DicerosB/SparrowCompass/Software/CubeIDE/Screenshot 2025-11-19 004516.jpg

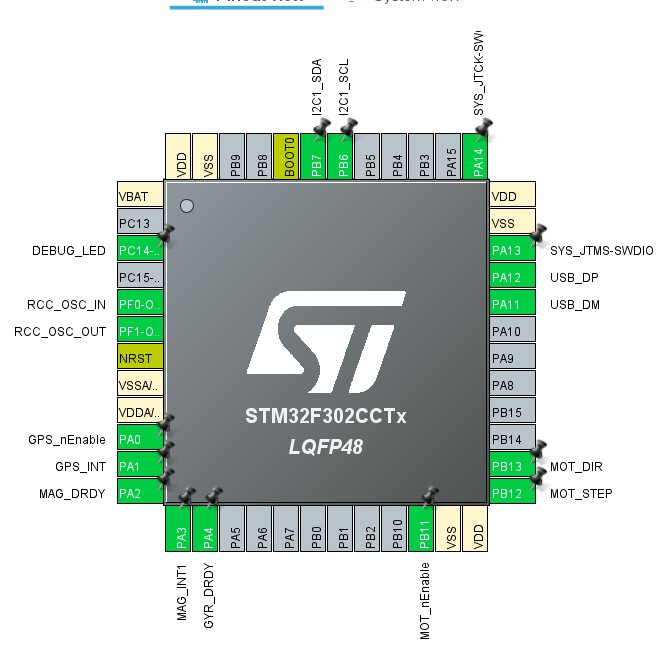
Software/CubeIDE/Screenshot 2025-11-19 004516.jpg
