DicerosB/SparrowCompass/Hardware/Revision2.0/BOM.xlsx

Reference | Qty | Value | DNP | Footprint | Datasheet | Cost | Link | total
C1;C2;C3;C6;C8;C11;C16;C19;C21;C23;C25;C31 | 12 | 2u2 |  | Capacitor_SMD:C_0603_1608Metric | ~ | 0.09 | https://www.mouser.de/ProductDetail/Murata-Electronics/GRM188C81C225MA12D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 | 1.08
C4;C5;C9;C12;C17;C18;C20;C22;C24;C28 | 10 | 100n |  | Capacitor_SMD:C_0603_1608Metric | ~ | 0.09 | https://www.mouser.de/ProductDetail/KEMET/C0603C104Z4VACTU?qs=t9q%2F2xDdjt80hHjNGtEgzg%3D%3D | 0.9
C7;C10 | 2 | 10u |  | Capacitor_SMD:CP_Elec_4x5.3 | ~ | 0.05 | https://www.mouser.de/ProductDetail/Knowles-Illinois-Capacitor/AVEZ106M16B12T-F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 | 0.1
C13;C14;C15;C29;C30 | 5 | 220n |  | Capacitor_SMD:C_0603_1608Metric | ~ | 0.09 | https://www.mouser.de/ProductDetail/Murata-Electronics/GRM188R71E224JA88J?qs=QzBtWTOodeUQv4s17XcJEQ%3D%3D | 0.45
C26;C27 | 2 | 6p |  | Capacitor_SMD:C_0603_1608Metric | ~ | 0.09 | https://www.mouser.de/ProductDetail/Murata-Electronics/GCM1885C2A6R0CA16D?qs=QzBtWTOodeW2ALKkh2LyBA%3D%3D | 0.18
D1;D2;D3;D4;D5;D6;D7 | 7 | LED |  | LED_SMD:LED_0603_1608Metric | ~ | 0.15 | https://www.mouser.de/ProductDetail/Wurth-Elektronik/150060BS75000?qs=LlUlMxKIyB2DLLpXQThavA%3D%3D | 1.05
IC1 | 1 | NEO-M8N-0 |  | NEO-M8N-0:NEO-M8T | https://www.u-blox.com/sites/default/files/NEO-M8-FW3_DataSheet_%28UBX-15031086%29.pdf | 27.09 | https://www.mouser.de/ProductDetail/u-blox/NEO-M8N-0?qs=zW32dvEIR3unZhZI0KRbew%3D%3D | 27.09
IC2 | 1 | LSM303AGRTR |  | LSM303AGRTR:LGA-12 | http://www.st.com/content/ccc/resource/technical/document/datasheet/74/c4/19/54/62/c5/46/13/DM00177685.pdf/files/DM00177685.pdf/jcr:content/translations/en.DM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 | 4 | https://www.mouser.de/ProductDetail/STMicroelectronics/LSM303AGRTR?qs=dTJS0cRn7oj2TlQhcroMCw%3D%3D | 4
IC3 | 1 | DRV8834RGER |  | DRV8834RGER:QFN50P400X400X100-25N-D | http://www.ti.com/lit/gpn/drv8834 | 2.35 | https://www.mouser.de/ProductDetail/Texas-Instruments/DRV8834RGER?qs=UFc95S4Z4CbZvVPj6YuR6w%3D%3D | 2.35
IC4 | 1 | AEDR-8300-1Q2 |  | AEDR-8300-1Q2:AEDR83001Q2 | https://www.digikey.ph/en/products/detail/broadcom-limited/AEDR-8300-1Q2/4573056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 | 8.31 | https://www.mouser.de/ProductDetail/Broadcom-Avago/AEDR-8300-1Q2?qs=RuhU64sK2%252Bt%252BHTtC7LwVEw%3D%3D | 8.31
IC6 | 1 | MCP73833T-AMI_MF |  | MCP73833T-AMI_MF:SON50P300X300X100-11N-D | https://datasheet.datasheetarchive.com/originals/distributors/SFDatasheet-4/sf-00090109.pdf | 0.98 | https://www.mouser.de/ProductDetail/Microchip-Technology/MCP73833T-AMI-MF?qs=Fxu3fLyJv8epbqy6GsGQQA%3D%3D | 0.98
J2 | 1 | Conn_Coaxial_Small |  | Connector_Coaxial:U.FL_Hirose_U.FL-R-SMT-1_Vertical | ~ | 1.25 | https://www.mouser.de/ProductDetail/Hirose-Connector/U.FL-R-SMT-110?qs=kL1ClTr6oBoOdtqlGQpQrQ%3D%3D | 1.25
J3 | 1 | USB4105-GF-A-060 |  | USB4105_GF_A_060:GCT_USB4105-GF-A-060 |  | 0.67 | https://www.mouser.de/ProductDetail/GCT/USB4105-GF-A-060?qs=QNEnbhJQKvY2mocwNJzgfA%3D%3D | 0.67
L1 | 1 | 220R |  | Inductor_SMD:L_1210_3225Metric | ~ | 3.06 | https://www.mouser.de/ProductDetail/Wurth-Elektronik/7687709221?qs=sq%252BaO8iX7yo5Y4jfKYVibg%3D%3D | 3.06
PS1;PS2 | 2 | ZLDO1117QG33TA |  | ZLDO1117QG33TA:SOT230P700X180-4N | https://www.diodes.com//assets/Datasheets/products_inactive_data/ZLDO1117.pdf | 0.46 | https://www.mouser.de/ProductDetail/Diodes-Incorporated/ZLDO1117QG33TA?qs=AsTZqt%2FmeqkYux4yhEuliw%3D%3D | 0.92
R1;R2 | 2 | 5k1 |  | Resistor_SMD:R_0603_1608Metric | ~ | 0.09 | https://www.mouser.de/ProductDetail/Vishay/CRCW06035K11FKEA?qs=2Ta4L6IlF3huCvbRI1eJUw%3D%3D | 0.18
R3;R4;R5;R14;R17;R21;R22;R23 | 8 | 470R |  | Resistor_SMD:R_0603_1608Metric | ~ | 0.09 |  | 0.72
R6 | 1 | 1k |  | Resistor_SMD:R_0603_1608Metric | ~ | 0.09 |  | 0.09
R7 | 1 | 80R |  | Resistor_SMD:R_0603_1608Metric | ~ | 0.09 |  | 0.09
R8;R9 | 2 | 200R |  | Resistor_SMD:R_0603_1608Metric | ~ | 0.09 |  | 0.18
R10 | 1 | 330R |  | Resistor_SMD:R_0603_1608Metric | ~ | 0.09 |  | 0.09
R11;R12;R13;R15;R16;R18;R19;R24 | 8 | 10k |  | Resistor_SMD:R_0603_1608Metric | ~ | 0.09 |  | 0.72
R20 | 1 | 20k |  | Resistor_SMD:R_0603_1608Metric | ~ | 0.09 |  | 0.09
U1 | 1 | L3GD20 |  | Package_LGA:LGA-16_4x4mm_P0.65mm_LayoutBorder4x4y | http://www.st.com/st-web-ui/static/active/en/resource/technical/document/datasheet/DM00036465.pdf | 14.03 | https://www.mouser.de/ProductDetail/STMicroelectronics/A3G4250DTR?qs=Ld7sMN6XJzCU8%252BkHd1RE7g%3D%3D | 14.03
U2 | 1 | TPD2EUSB30 |  | Package_TO_SOT_SMD:Texas_DRT-3 | http://www.ti.com/lit/ds/symlink/tpd2eusb30a.pdf | 0.48 | https://www.mouser.de/ProductDetail/Texas-Instruments/TPD2EUSB30DRTR?qs=%2Fqzd9s%252BcLd6bPJi5HXCDvw%3D%3D | 0.48
U3 | 1 | STM32F302CCTx |  | Package_QFP:LQFP-48_7x7mm_P0.5mm | https://www.st.com/resource/en/datasheet/stm32f302cc.pdf | 5.23 | https://www.mouser.de/ProductDetail/STMicroelectronics/STM32F302CCT7?qs=NoqMqJKvPFJLAf54HThcFA%3D%3D | 5.23
Y1 | 1 | XRCGB25M000F3M00R0 |  | XRCGB25M000F3M00R0:XRCGB | https://www.murata.com/products/productdata/8801059864606/SPEC-XRCGB25M000F3M00R0.pdf | 0.215 | https://www.mouser.de/ProductDetail/Murata-Electronics/XRCGB25M000F3M00R0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 | 0.215
 |  | RFID Module |  |  |  | 5.67 | https://funduinoshop.com/elektronische-module/wireless-iot/rfid-nfc/pn532-nfc-rfid-v3-modul-fuer-arduino-und-co. | 5.67
 |  | GPS Antenna |  |  |  | 3.15 | https://www.mouser.de/ProductDetail/KYOCERA-AVX/9000440F0-AA12L0150?qs=jRuttqqUwMS53dQeffbIFQ%3D%3D | 3.15
 |  | Nema-Flat Stepper Motor |  |  |  | 22.5 | https://www.reichelt.de/de/de/shop/produkt/schrittmotor_nema_flat02_1_8_0_5_a_1_75_v-335315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 | 22.5
 |  |  |  |  |  |  | + PCB | 14
 |  |  |  |  |  |  | Summe: | 119.825
