DicerosB/SparrowCompass/Hardware/component_lib/LIB_EE-SX1320/EE-SX1320/3D/EE-SX1320.stp

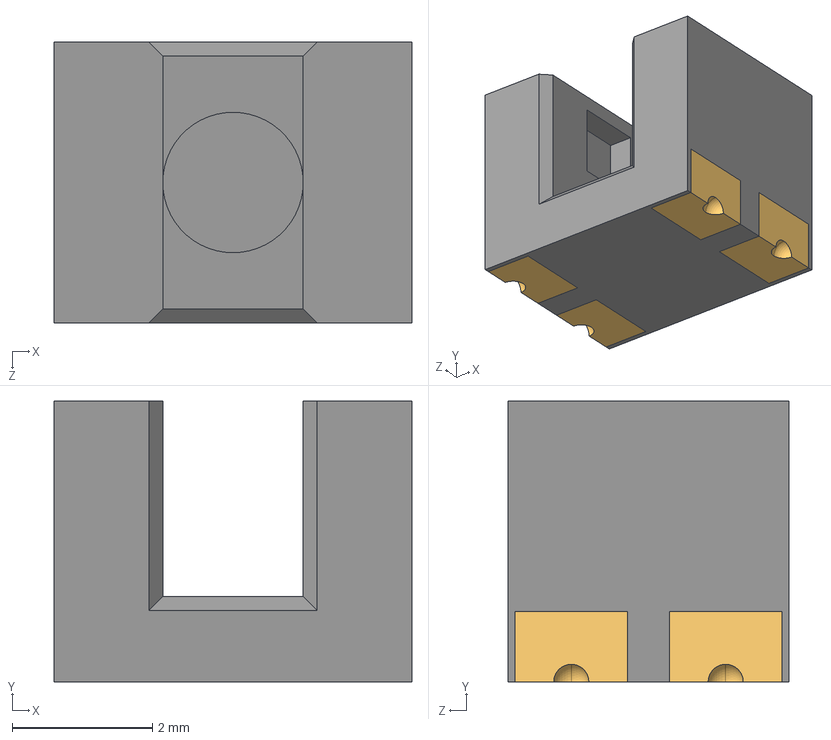
[picture p2: CAD file, 2026-05-11]
Hardware/component_lib/LIB_EE-SX1320/EE-SX1320/3D/EE-SX1320.stp
5.10 x 4.00 x 4.00 mm
