DicerosB/SparrowCompass/Hardware/component_lib/LIB_LDL1117S33R/LDL1117S33R/3D/LDL1117S33R.stp

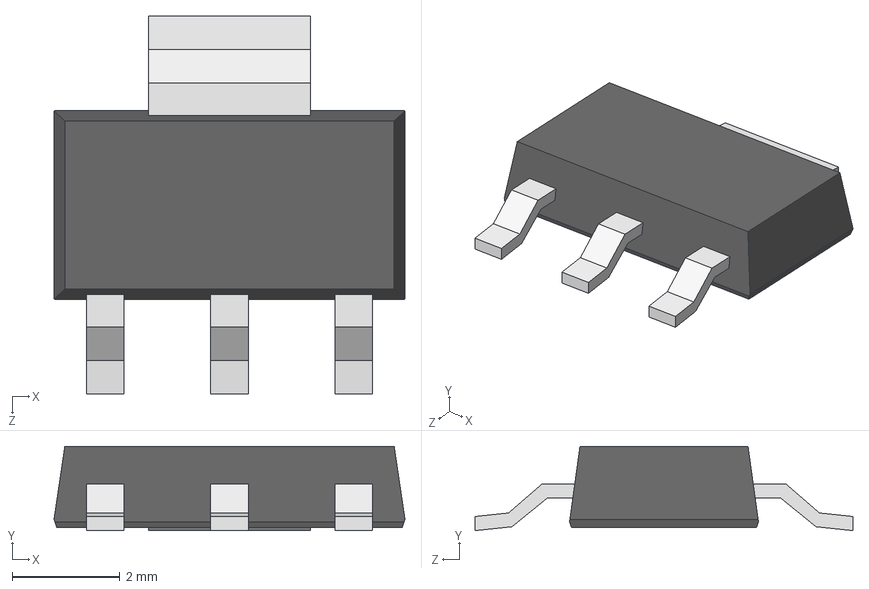
[picture p3: CAD file, 2026-05-11]
Hardware/component_lib/LIB_LDL1117S33R/LDL1117S33R/3D/LDL1117S33R.stp
6.50 x 1.56 x 7.00 mm
