DicerosB/SparrowCompass/Hardware/component_lib/LIB_LSM9DS1TR/LSM9DS1TR/3D/LSM9DS1TR.stp

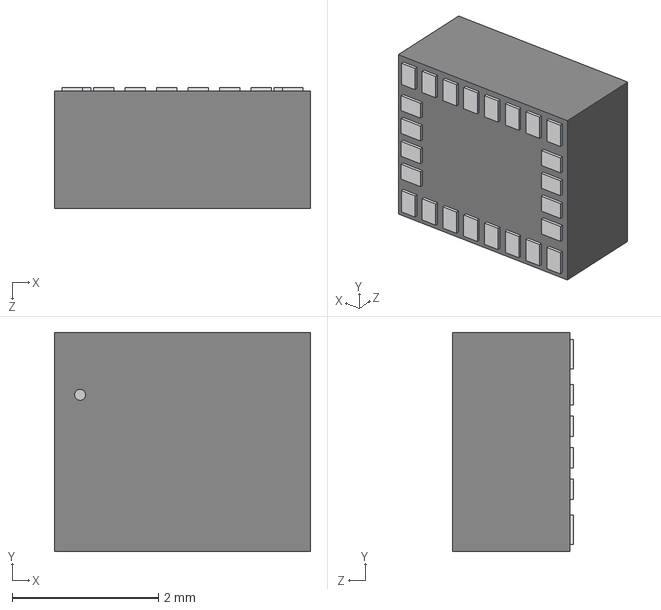
[picture p4: CAD file, 2026-05-11]
Hardware/component_lib/LIB_LSM9DS1TR/LSM9DS1TR/3D/LSM9DS1TR.stp
3.50 x 3.00 x 1.65 mm
