DicerosB/SparrowCompass/Hardware/component_lib/LIB_TESEO-LIV3F/TESEO-LIV3F/3D/TESEO-LIV3F.stp

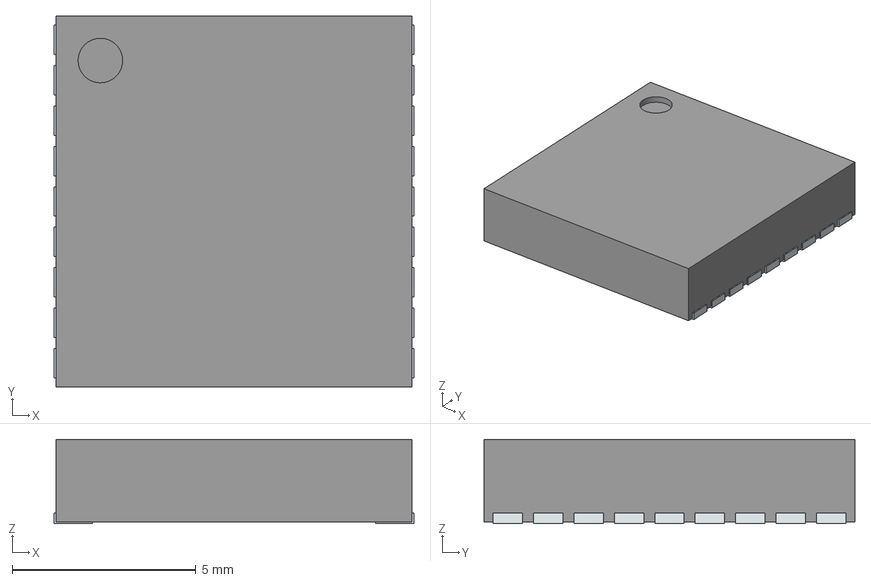
[picture p5: CAD file, 2026-05-11]
Hardware/component_lib/LIB_TESEO-LIV3F/TESEO-LIV3F/3D/TESEO-LIV3F.stp
9.80 x 10.1 x 2.30 mm
PinsArrayLR
