DicerosB/SparrowCompass/Hardware/component_lib/LIB_XC6806A42011-G/XC6806A42011-G/3D/XC6806A42011-G.stp

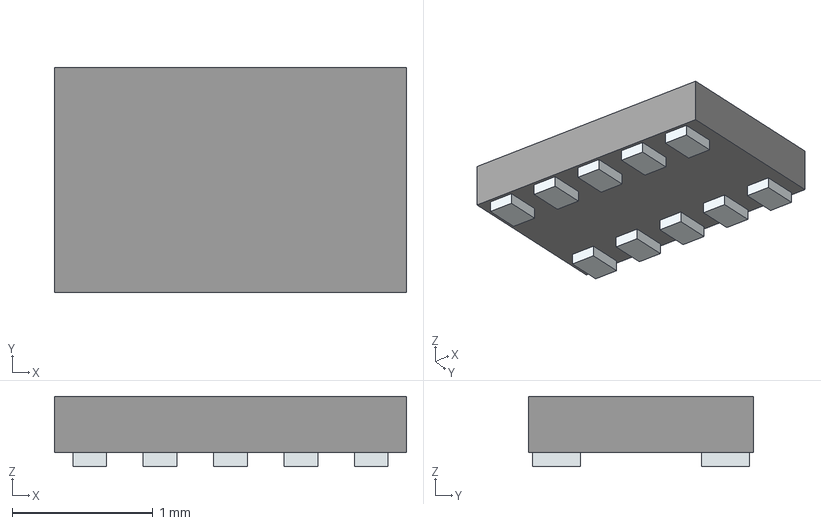
[picture p6: CAD file, 2026-05-11]
Hardware/component_lib/LIB_XC6806A42011-G/XC6806A42011-G/3D/XC6806A42011-G.stp
2.50 x 1.60 x 0.5 mm
Pins
