DicerosB/SparrowCompass/Hardware/component_lib/LIB_JS102011SAQN/JS102011SAQN/3D/JS102011SAQN.stp

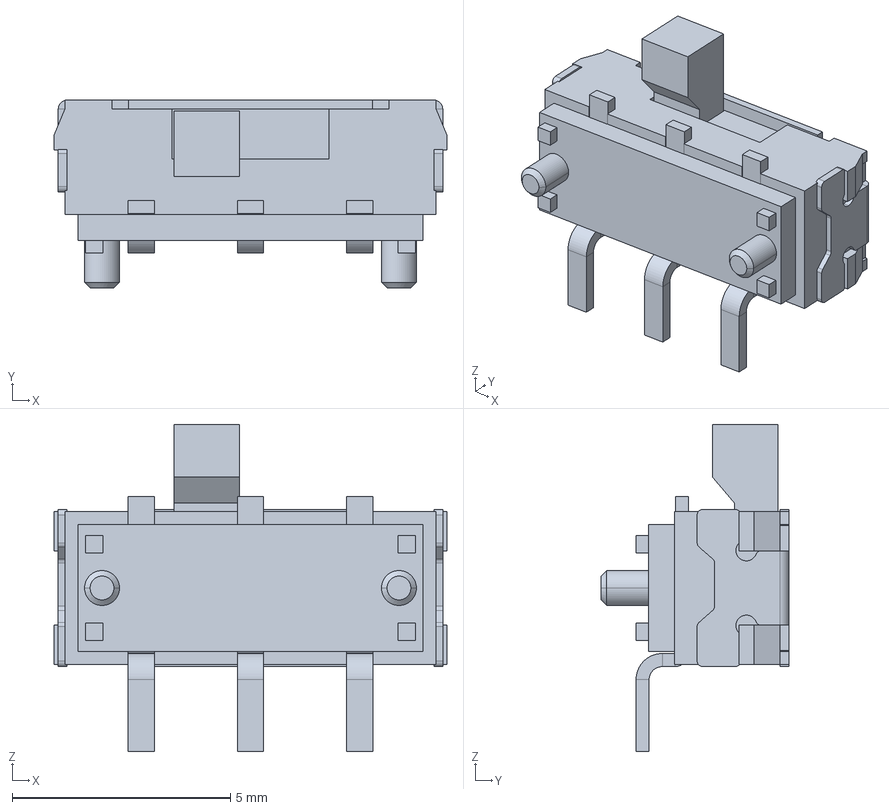
[picture p7: CAD file, 2026-05-22]
Hardware/component_lib/LIB_JS102011SAQN/JS102011SAQN/3D/JS102011SAQN.stp
9.00 x 4.30 x 7.50 mm
