DicerosB/SparrowCompass/(list of files, cad)

Other CAD files:
Hardware/component_lib/LIB_EE-SX1320/EE-SX1320/Allegro/ee-sx1320.psm
Hardware/component_lib/LIB_EE-SX1320/EE-SX1320/DEHDL/ee_sx1320/chips/chips.prt
Hardware/component_lib/LIB_JS102011SAQN/JS102011SAQN/Allegro/js102011saqn.psm
Hardware/component_lib/LIB_JS102011SAQN/JS102011SAQN/DEHDL/js102011saqn/chips/chips.prt
Hardware/component_lib/LIB_LDL1117S33R/LDL1117S33R/Allegro/sot230p700x180-4n.psm
Hardware/component_lib/LIB_LDL1117S33R/LDL1117S33R/DEHDL/ldl1117s33r/chips/chips.prt
Hardware/component_lib/LIB_LSM9DS1TR/LSM9DS1TR/Allegro/lga-24l_3x3_5x1mm_.psm
Hardware/component_lib/LIB_LSM9DS1TR/LSM9DS1TR/DEHDL/lsm9ds1tr/chips/chips.prt
Hardware/component_lib/LIB_TESEO-LIV3F/TESEO-LIV3F/Allegro/son110p970x1010x230-18n.psm
Hardware/component_lib/LIB_TESEO-LIV3F/TESEO-LIV3F/DEHDL/teseo_liv3f/chips/chips.prt
Hardware/component_lib/LIB_XC6806A42011-G/XC6806A42011-G/Allegro/xc6806a42011g.psm
Hardware/component_lib/LIB_XC6806A42011-G/XC6806A42011-G/DEHDL/xc6806a42011_g/chips/chips.prt
