DicerosB/SparrowCompass/TODO.md

# Hardware

## Schematic

- fanout remaining GPIO
- dim all LEDs
- reinforce power
- current limit Motor driver
- make microstepping configurable
- protect Reset Line
- add on/off switch

## Dimension

- shrink overall dimensions
- relocate important LEDs

## Parts

- add RFID Reader
- mabye add Display

# Software

## Arduino Library

## Bootloader

# Documentation
