DicerosB/SparrowCompass/Hardware/Revision2.0/SparrowCompass.pdf

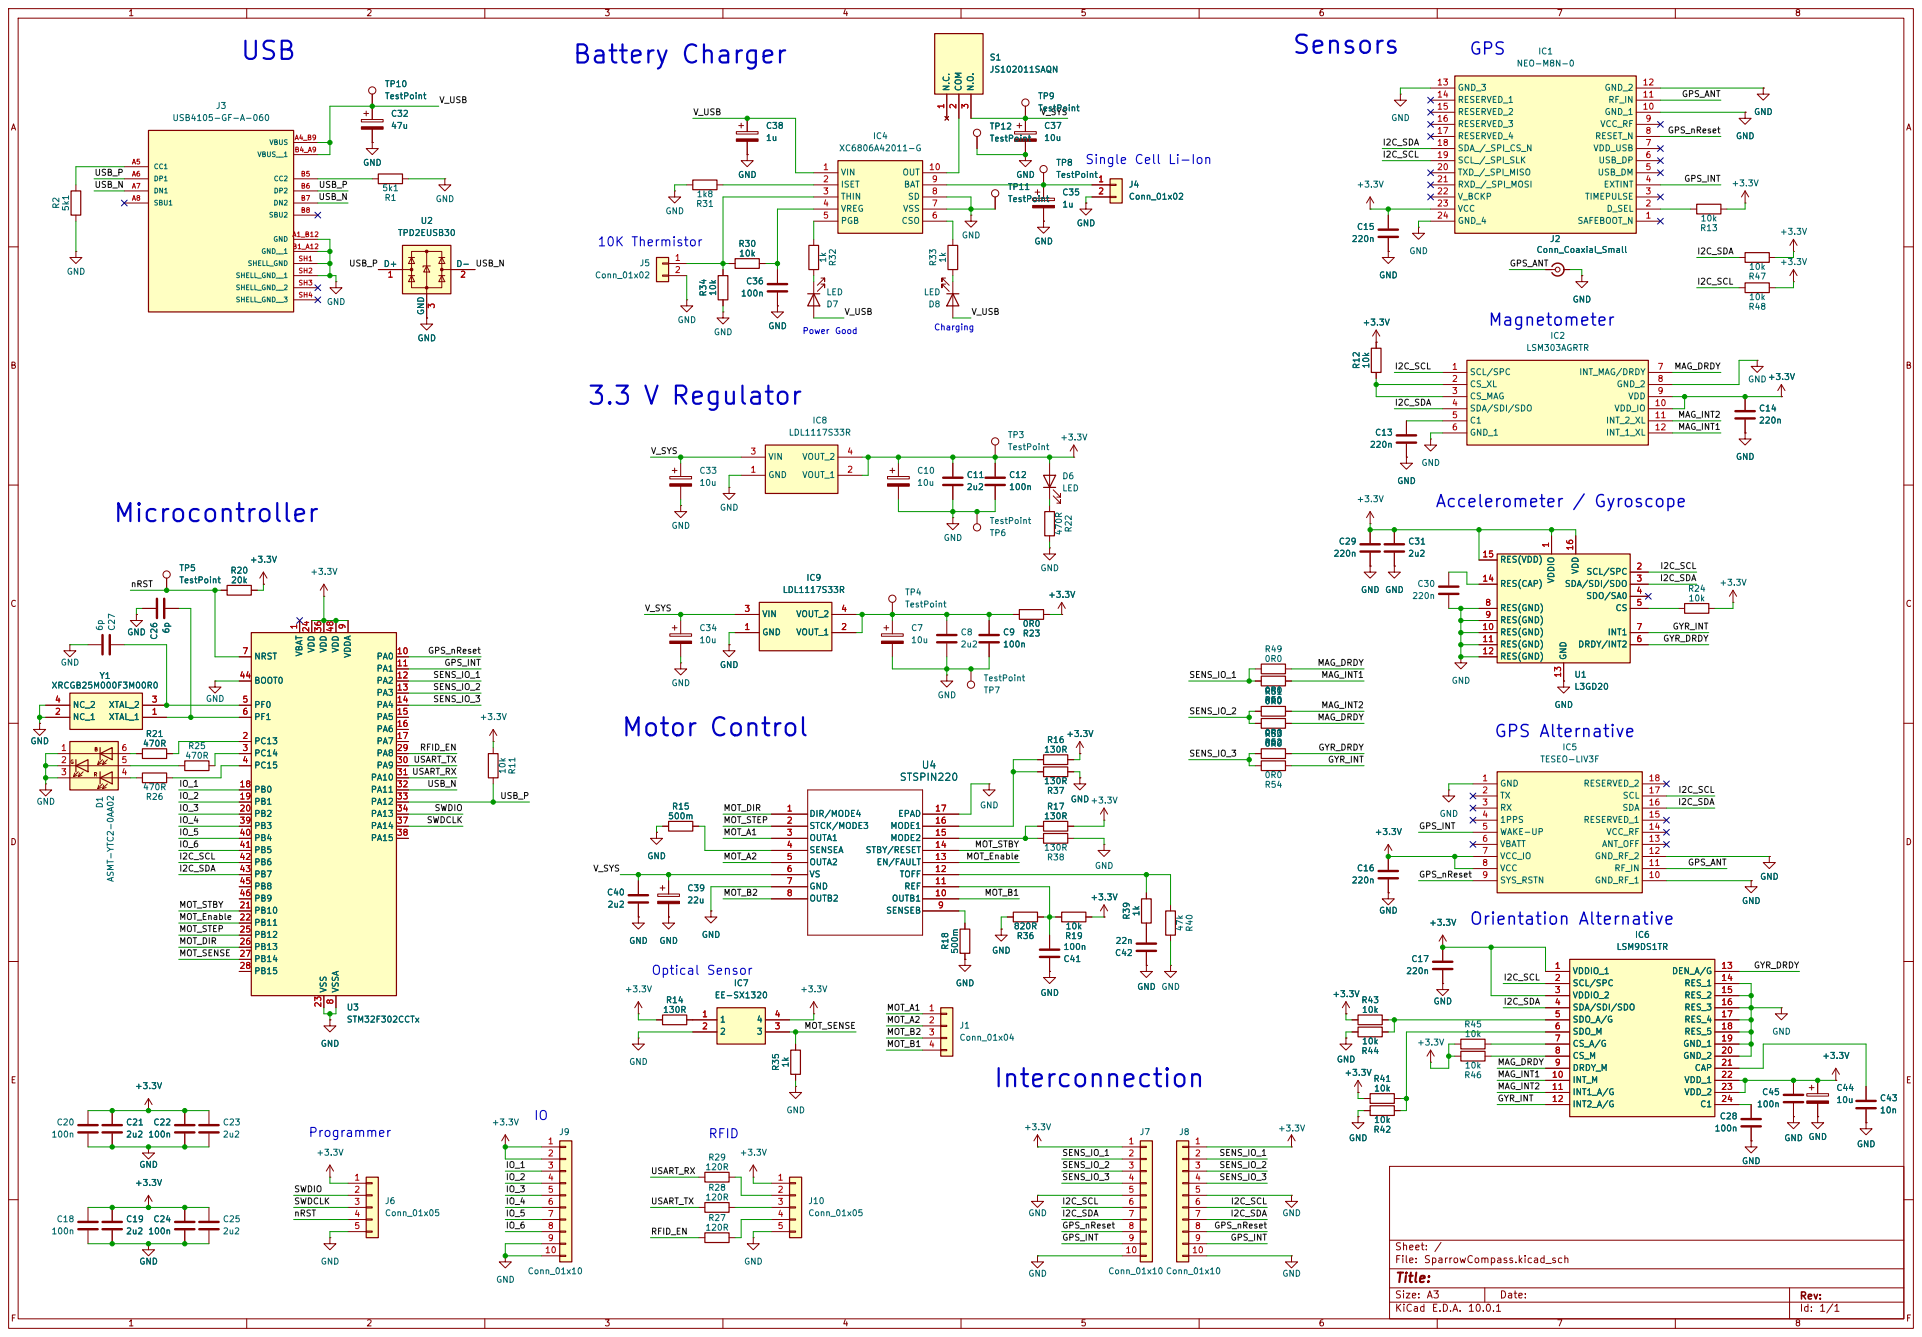
[picture p8: page 1]

Size: A3 | Rev: | F Date:
KiCad E.D.A. 10.0.1 | Id: 1/1
