DicerosB/SparrowCompass/(list of files, drawings)

Other design files:
Hardware/component_lib/LIB_JS102011SAQN/JS102011SAQN/Altium/JS102011SAQN.PcbLib
Hardware/component_lib/LIB_JS102011SAQN/JS102011SAQN/Altium/JS102011SAQN.SchLib
Hardware/component_lib/LIB_LDL1117S33R/LDL1117S33R/Altium/LDL1117S33R.SchLib
Hardware/component_lib/LIB_LDL1117S33R/LDL1117S33R/Altium/SOT230P700X180-4N.PcbLib
Hardware/component_lib/LIB_TESEO-LIV3F/TESEO-LIV3F/Altium/SON110P970X1010X230-18N.PcbLib
Hardware/component_lib/LIB_TESEO-LIV3F/TESEO-LIV3F/Altium/TESEO-LIV3F.SchLib
Hardware/component_lib/LIB_XC6806A42011-G/XC6806A42011-G/Altium/XC6806A42011-G.SchLib
Hardware/component_lib/LIB_XC6806A42011-G/XC6806A42011-G/Altium/XC6806A42011G.PcbLib
