DicerosB/SparrowCompass/Hardware/Revision2.0/SparrowCompass.kicad_pcb

## KiCad design Hardware/Revision2.0/SparrowCompass.kicad_pcb (2026-06-11)

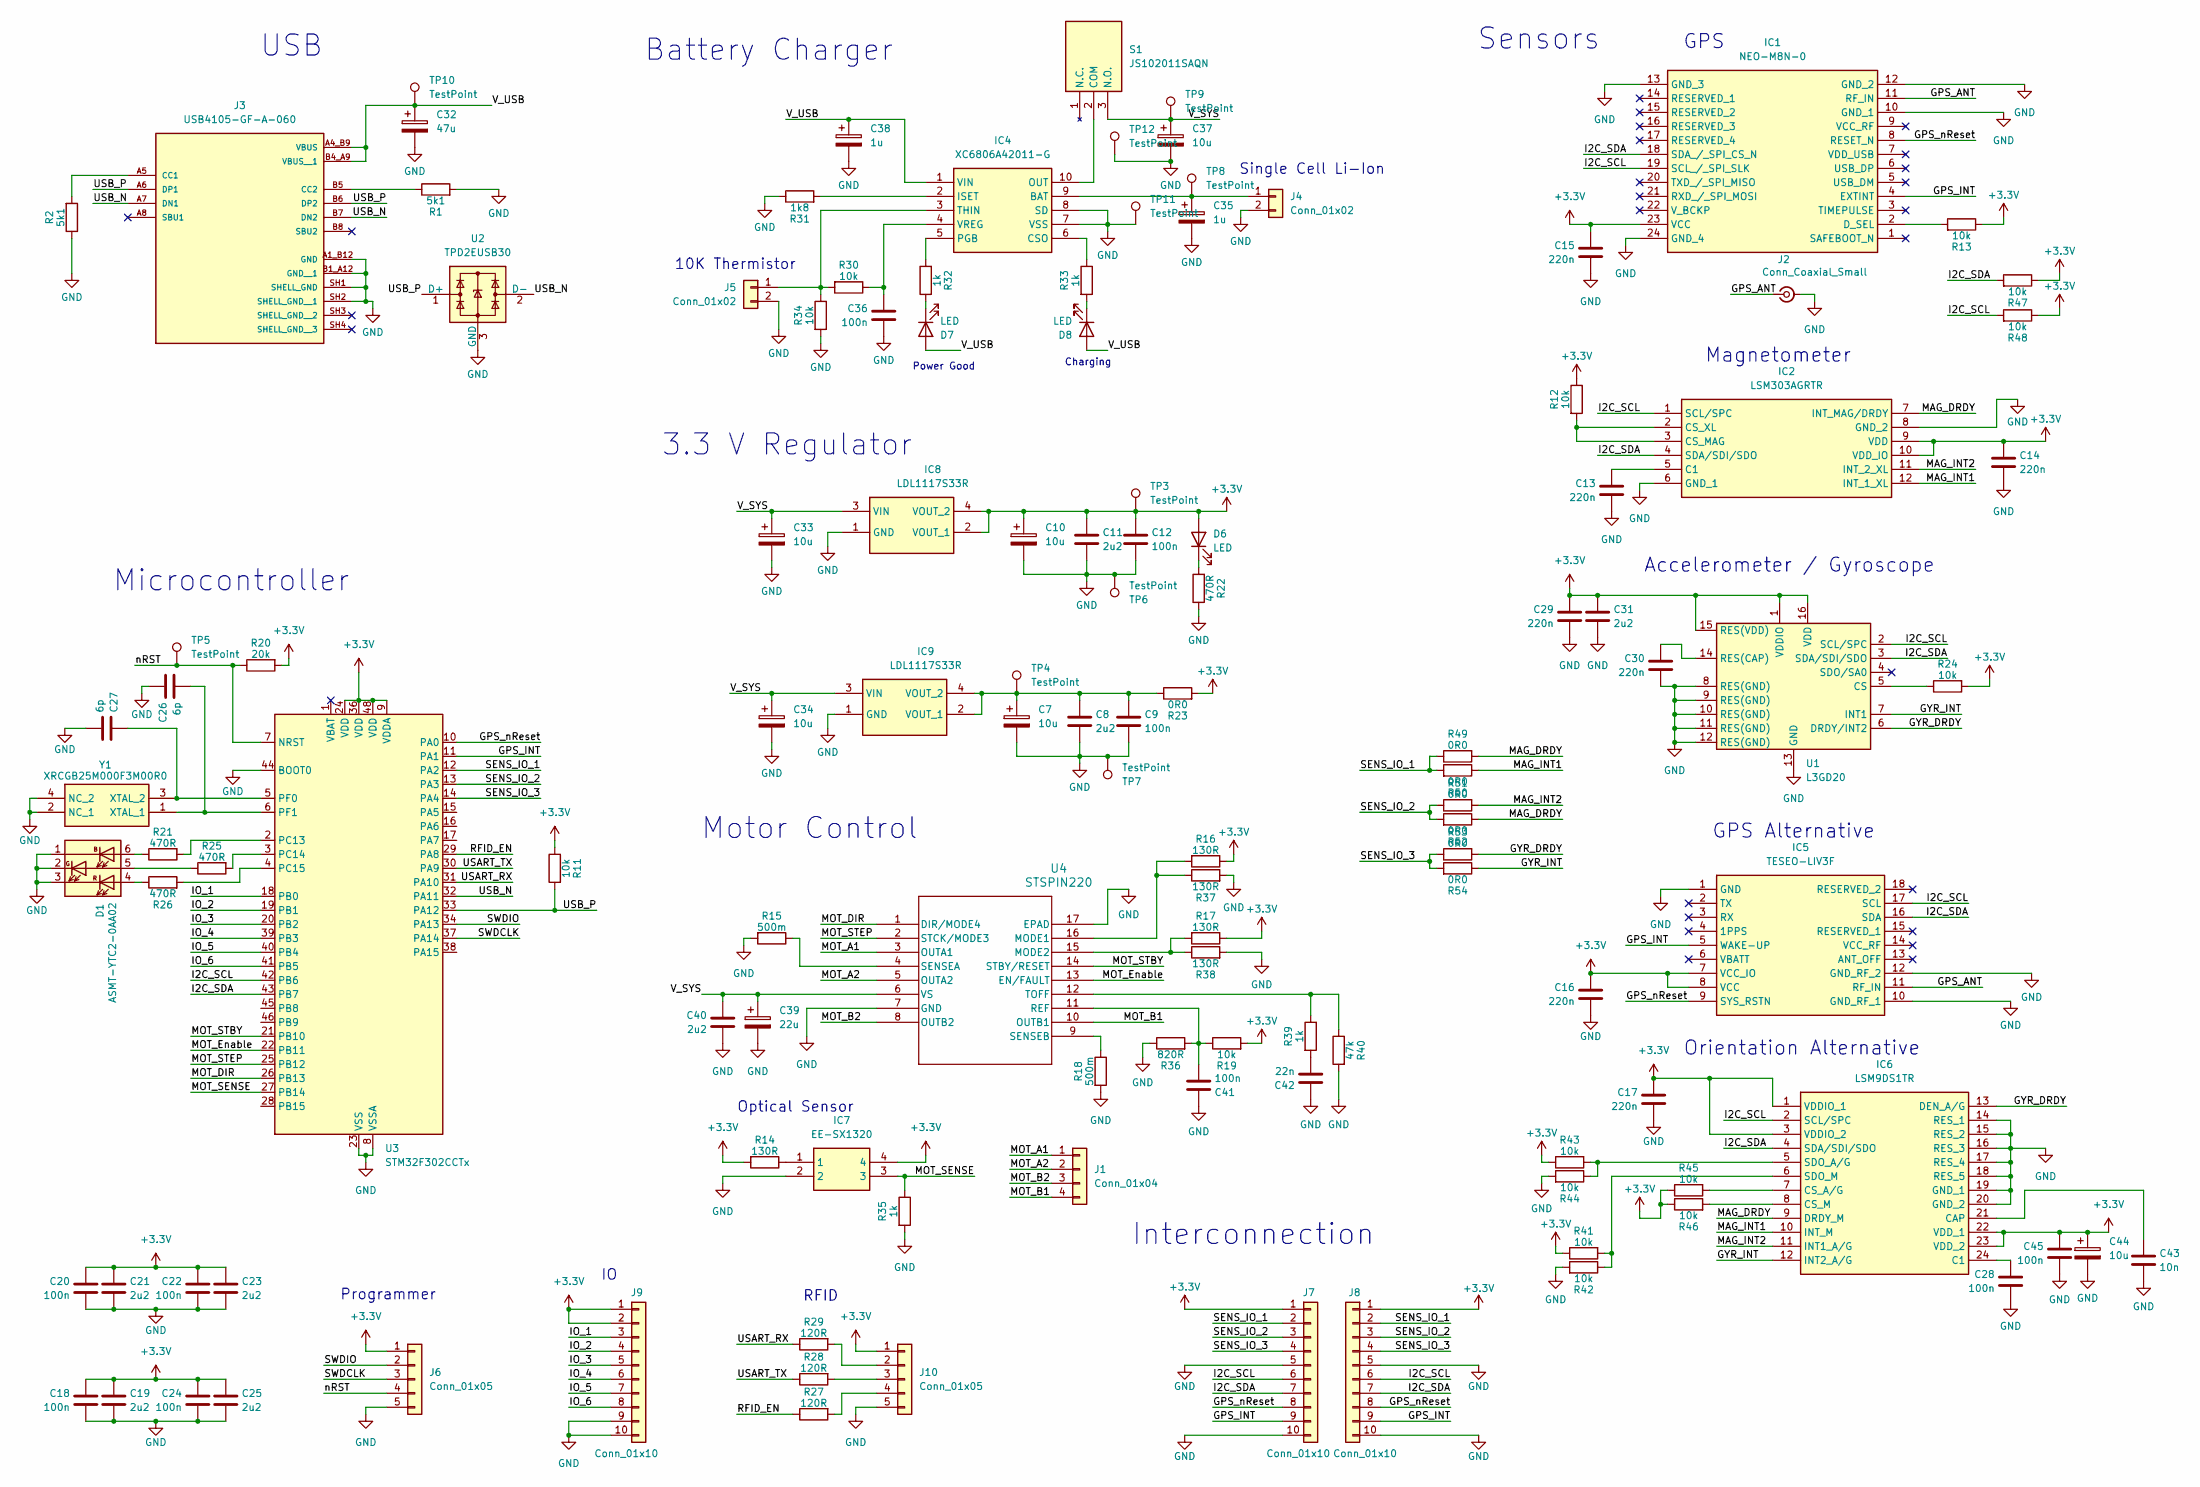
[picture p9: schematic SparrowCompass.kicad_sch]

Parts:
C7, C10, C33, C34, C37, C44: 10u; CP_EIA-6032-15_Kemet-U
C8, C11, C19, C21, C23, C25, C31, C40: 2u2; C_0603_1608Metric
C9, C12, C18, C20, C22, C24, C28, C36, C41, C45: 100n; C_0603_1608Metric
C13, C14, C15, C16, C17, C29, C30: 220n; C_0603_1608Metric
C26, C27: 6p; C_0603_1608Metric
C32: 47u; CP_EIA-6032-15_Kemet-U
C35, C38: 1u; CP_EIA-6032-15_Kemet-U
C39: 22u; CP_EIA-6032-15_Kemet-U
C42: 22n; C_0603_1608Metric
C43: 10n; C_0603_1608Metric
D1: ASMT-YTC2-0AA02; LED_Avago_PLCC6_3x2.8mm
D6, D7, D8: LED; LED_0603_1608Metric
IC1: NEO-M8N-0; NEO-M8T; Mouser Part Number 377-NEO-M8N-0
IC2: LSM303AGRTR; LGA-12; Mouser Part Number 511-LSM303AGRTR
IC4: XC6806A42011-G; XC6806A42011G; Manufacturer_Part_Number XC6806A42011-G
IC5: TESEO-LIV3F; SON110P970X1010X230-18N; Manufacturer_Part_Number TESEO-LIV3F
IC6: LSM9DS1TR; LGA-24L_3X3.5X1MM_; Manufacturer_Part_Number LSM9DS1TR
IC7: EE-SX1320; Mouser Part Number 653-EESX1320
IC8, IC9: LDL1117S33R; SOT230P700X180-4N; Manufacturer_Part_Number LDL1117S33R
J1: Conn_01x04; PinHeader_1x04_P2.54mm_Vertical
J2: Conn_Coaxial_Small; U.FL_Hirose_U.FL-R-SMT-1_Vertical
J3: USB4105-GF-A-060; GCT_USB4105-GF-A-060; PARTREV B3
J4, J5: Conn_01x02; PinHeader_1x02_P2.54mm_Vertical
J6, J10: Conn_01x05; PinHeader_1x05_P2.54mm_Vertical
J7, J8, J9: Conn_01x10; PinHeader_1x10_P1.27mm_Vertical
R1, R2: 5k1; R_0603_1608Metric
R11, R12, R13, R19, R24, R30, R34, R41, R42, R43, R44, R45, R46, R47, R48: 10k; R_0603_1608Metric
R14, R16, R17, R37, R38: 130R; R_0603_1608Metric
R15, R18: 500m; R_0603_1608Metric
R20: 20k; R_0603_1608Metric
R21, R22, R25, R26: 470R; R_0603_1608Metric
R23, R49, R50, R51, R52, R53, R54: 0R0; R_0603_1608Metric
R27, R28, R29: 120R; R_0603_1608Metric
R31: 1k8; R_0603_1608Metric
R32, R33, R35, R39: 1k; R_0603_1608Metric
R36: 820R; R_0603_1608Metric
R40: 47k; R_0603_1608Metric
S1: JS102011SAQN; Manufacturer_Part_Number JS102011SAQN
TP3, TP4, TP5, TP6, TP7, TP8, TP9, TP10, TP11, TP12: TestPoint; TestPoint_THTPad_D1.0mm_Drill0.5mm
U1: L3GD20; LGA-16_4x4mm_P0.65mm_LayoutBorder4x4y
U2: TPD2EUSB30; Texas_DRT-3
U3: STM32F302CCTx; LQFP-48_7x7mm_P0.5mm
U4: STSPIN220; VFQFPN-16_STM
Y1: XRCGB25M000F3M00R0; XRCGB; Mouser Part Number 81-XRCGB25M000F3M0R0

Connections:
+3.3V: C10.1, C11.1, C12.1, C14.1, C15.1, C16.1, C17.1, C18.1, C19.1, C20.1, C21.1, C22.1, C23.1, C24.1, C25.1, C29.1, C31.1, C44.1, C45.1, D6.2 (A), IC1.23 (VCC), IC2.9 (VDD), IC2.10 (VDD_IO), IC5.7 (VCC_IO), IC5.8 (VCC), IC6.1 (VDDIO_1), IC6.3 (VDDIO_2), IC6.22 (VDD_1), IC6.23 (VDD_2), IC7.4, IC8.2 (VOUT_1), IC8.4 (VOUT_2), J6.1, J7.1, J8.1, J9.1, J9.2, J10.1, R11.1, R12.1, R13.1, R14.2, R16.1, R17.1, R19.2, R20.2, R23.2, R24.2, R41.1, R43.1, R45.1, R46.1, R47.1, R48.1, TP3.1 (1_1), U1.1 (VDDIO), U1.15 (RES(VDD)), U1.16 (VDD), U3.9 (VDDA), U3.24 (VDD), U3.36 (VDD), U3.48 (VDD)
/GPS_ANT: IC1.11 (RF_IN), IC5.11 (RF_IN), J2.1 (In)
/GPS_INT: IC1.4 (EXTINT), IC5.5 (WAKE-UP), J7.9, J8.9, U3.11 (PA1)
/GPS_nReset: IC1.8 (RESET_N), IC5.9 (SYS_RSTN), J7.8, J8.8, U3.10 (PA0)
/GYR_DRDY: IC6.13 (DEN_A/G), R53.2, U1.6 (DRDY/INT2)
/GYR_INT: IC6.12 (INT2_A/G), R54.1, U1.7 (INT1)
/I2C_SCL: IC1.19 (SCL_/_SPI_SLK), IC2.1 (SCL/SPC), IC5.17 (SCL), IC6.2 (SCL/SPC), J7.6, J8.6, R48.2, U1.2 (SCL/SPC), U3.42 (PB6)
/I2C_SDA: IC1.18 (SDA_/_SPI_CS_N), IC2.4 (SDA/SDI/SDO), IC5.16 (SDA), IC6.4 (SDA/SDI/SDO), J7.7, J8.7, R47.2, U1.3 (SDA/SDI/SDO), U3.43 (PB7)
/IO_1: J9.3, U3.18 (PB0)
/IO_2: J9.4, U3.19 (PB1)
/IO_3: J9.5, U3.20 (PB2)
/IO_4: J9.6, U3.39 (PB3)
/IO_5: J9.7, U3.40 (PB4)
/IO_6: J9.8, U3.41 (PB5)
/MAG_DRDY: IC2.7 (INT_MAG/DRDY), IC6.9 (DRDY_M), R49.2, R52.1
/MAG_INT1: IC2.12 (INT_1_XL), IC6.10 (INT_M), R50.1
/MAG_INT2: IC2.11 (INT_2_XL), IC6.11 (INT1_A/G), R51.2
/MOT_A1: J1.1, U4.3 (OUTA1)
/MOT_A2: J1.2, U4.5 (OUTA2)
/MOT_B1: J1.4, U4.10 (OUTB1)
/MOT_B2: J1.3, U4.8 (OUTB2)
/MOT_DIR: U3.26 (PB13), U4.1 (DIR/MODE4)
/MOT_Enable: U3.22 (PB11), U4.13 (EN/FAULT)
/MOT_SENSE: IC7.3, R35.1, U3.27 (PB14)
/MOT_STBY: U3.21 (PB10), U4.14 (STBY/RESET)
/MOT_STEP: U3.25 (PB12), U4.2 (STCK/MODE3)
/RFID_EN: R27.1, U3.29 (PA8)
/SENS_IO_1: J7.2, J8.2, R49.1, R50.2, U3.12 (PA2)
/SENS_IO_2: J7.3, J8.3, R51.1, R52.2, U3.13 (PA3)
/SENS_IO_3: J7.4, J8.4, R53.1, R54.2, U3.14 (PA4)
/SWDCLK: J6.3, U3.37 (PA14)
/SWDIO: J6.2, U3.34 (PA13)
/USART_RX: R29.1, U3.31 (PA10)
/USART_TX: R28.1, U3.30 (PA9)
/USB_N: J3.A7 (DN1), J3.B7 (DN2), U2.2 (D-), U3.32 (PA11)
/USB_P: J3.A6 (DP1), J3.B6 (DP2), R11.2, U2.1 (D+), U3.33 (PA12)
/V_SYS: C33.1, C34.1, C37.1, C39.1, C40.1, IC8.3 (VIN), IC9.3 (VIN), S1.3 (N.O.), TP9.1 (1_1), U4.6 (VS)
/V_USB: C32.1, C38.1, D7.2 (A), D8.2 (A), IC4.1 (VIN), J3.A4_B9 (VBUS), J3.B4_A9 (VBUS__1), TP10.1 (1_1)
/nRST: J6.4, R20.1, TP5.1 (1_1), U3.7 (NRST)
GND: C7.2, C8.2, C9.2, C10.2, C11.2, C12.2, C13.2, C14.2, C15.2, C16.2, C17.2, C18.2, C19.2, C20.2, C21.2, C22.2, C23.2, C24.2, C25.2, C26.1, C27.2, C28.2, C29.2, C30.2, C31.2, C32.2, C33.2, C34.2, C35.2, C36.2, C37.2, C38.2, C39.2, C40.2, C41.1, C42.1, C43.2, C44.2, C45.2, D1.1 (KB), D1.2 (KG), D1.3 (KR), IC1.10 (GND_1), IC1.12 (GND_2), IC1.13 (GND_3), IC1.24 (GND_4), IC2.6 (GND_1), IC2.8 (GND_2), IC4.7 (VSS), IC4.8 (SD), IC5.1 (GND), IC5.10 (GND_RF_1), IC5.12 (GND_RF_2), IC6.14 (RES_1), IC6.15 (RES_2), IC6.16 (RES_3), IC6.17 (RES_4), IC6.18 (RES_5), IC6.19 (GND_1), IC6.20 (GND_2), IC7.2, IC8.1 (GND), IC9.1 (GND), J2.2 (Ext), J3.A1_B12 (GND), J3.B1_A12 (GND__1), J3.SH1 (SHELL_GND), J3.SH2 (SHELL_GND__1), J4.2, J5.2, J6.5, J7.5, J7.10, J8.5, J8.10, J9.9, J9.10, J10.5, R1.2, R2.1, R15.2, R18.2, R22.1, R31.1, R34.2, R35.2, R36.1, R37.2, R38.2, R40.2, R42.2, R44.2, TP6.1 (1_1), TP7.1 (1_1), TP11.1 (1_1), TP12.1 (1_1), U1.8 (RES(GND)), U1.9 (RES(GND)), U1.10 (RES(GND)), U1.11 (RES(GND)), U1.12 (RES(GND)), U1.13 (GND), U2.3 (GND), U3.8 (VSSA), U3.23 (VSS), U3.35 (VSS), U3.44 (BOOT0), U3.47 (VSS), U4.7 (GND), U4.17 (EPAD), Y1.2 (NC_1), Y1.4 (NC_2)
unnamed: C42.2, R39.2
unnamed: D1.6 (AB), R21.1
unnamed: D1.5 (AG), R25.1
unnamed: D1.4 (AR), R26.1
unnamed: D6.1 (K), R22.2
unnamed: D7.1 (K), R32.1
unnamed: D8.1 (K), R33.2
unnamed: IC1.2 (D_SEL), R13.2
unnamed: C13.1, IC2.5 (C1)
unnamed: IC2.2 (CS_XL), IC2.3 (CS_MAG), R12.2
unnamed: C35.1, IC4.9 (BAT), J4.1, TP8.1 (1_1)
unnamed: IC4.6 (CSO), R33.1
unnamed: IC4.2 (ISET), R31.2
unnamed: IC4.10 (OUT), S1.2 (COM)
unnamed: IC4.5 (PGB), R32.2
unnamed: IC4.3 (THIN), J5.1, R30.2, R34.1
unnamed: C36.1, IC4.4 (VREG), R30.1
unnamed: C28.1, IC6.24 (C1)
unnamed: C43.1, IC6.21 (CAP)
unnamed: IC6.7 (CS_A/G), R45.2
unnamed: IC6.8 (CS_M), R46.2
unnamed: IC6.5 (SDO_A/G), R43.2, R44.1
unnamed: IC6.6 (SDO_M), R41.2, R42.1
unnamed: IC7.1, R14.1
unnamed: C7.1, C8.1, C9.1, IC9.2 (VOUT_1), IC9.4 (VOUT_2), R23.1, TP4.1 (1_1)
unnamed: J3.A5 (CC1), R2.2
unnamed: J3.B5 (CC2), R1.1
unnamed: J10.2, R29.2
unnamed: J10.3, R28.2
unnamed: J10.4, R27.2
unnamed: R24.1, U1.5 (CS)
unnamed: C30.1, U1.14 (RES(CAP))
unnamed: R21.2, U3.2 (PC13)
unnamed: R25.2, U3.3 (PC14)
unnamed: R26.2, U3.4 (PC15)
unnamed: C27.1, U3.5 (PF0), Y1.3 (XTAL_2)
unnamed: C26.2, U3.6 (PF1), Y1.1 (XTAL_1)
unnamed: R16.2, R37.1, U4.16 (MODE1)
unnamed: R17.2, R38.1, U4.15 (MODE2)
unnamed: C41.2, R19.1, R36.2, U4.11 (REF)
unnamed: R15.1, U4.4 (SENSEA)
unnamed: R18.1, U4.9 (SENSEB)
unnamed: R39.1, R40.1, U4.12 (TOFF)

Notes on the sheet:
RFID
Optical Sensor
Battery Charger
3.3 V Regulator
Sensors
Charging
Single Cell Li-Ion
Orientation Alternative
10K Thermistor
GPS Alternative
Accelerometer / Gyroscope
Programmer
Motor Control
Microcontroller
Interconnection
Power Good
USB
Magnetometer
GPS

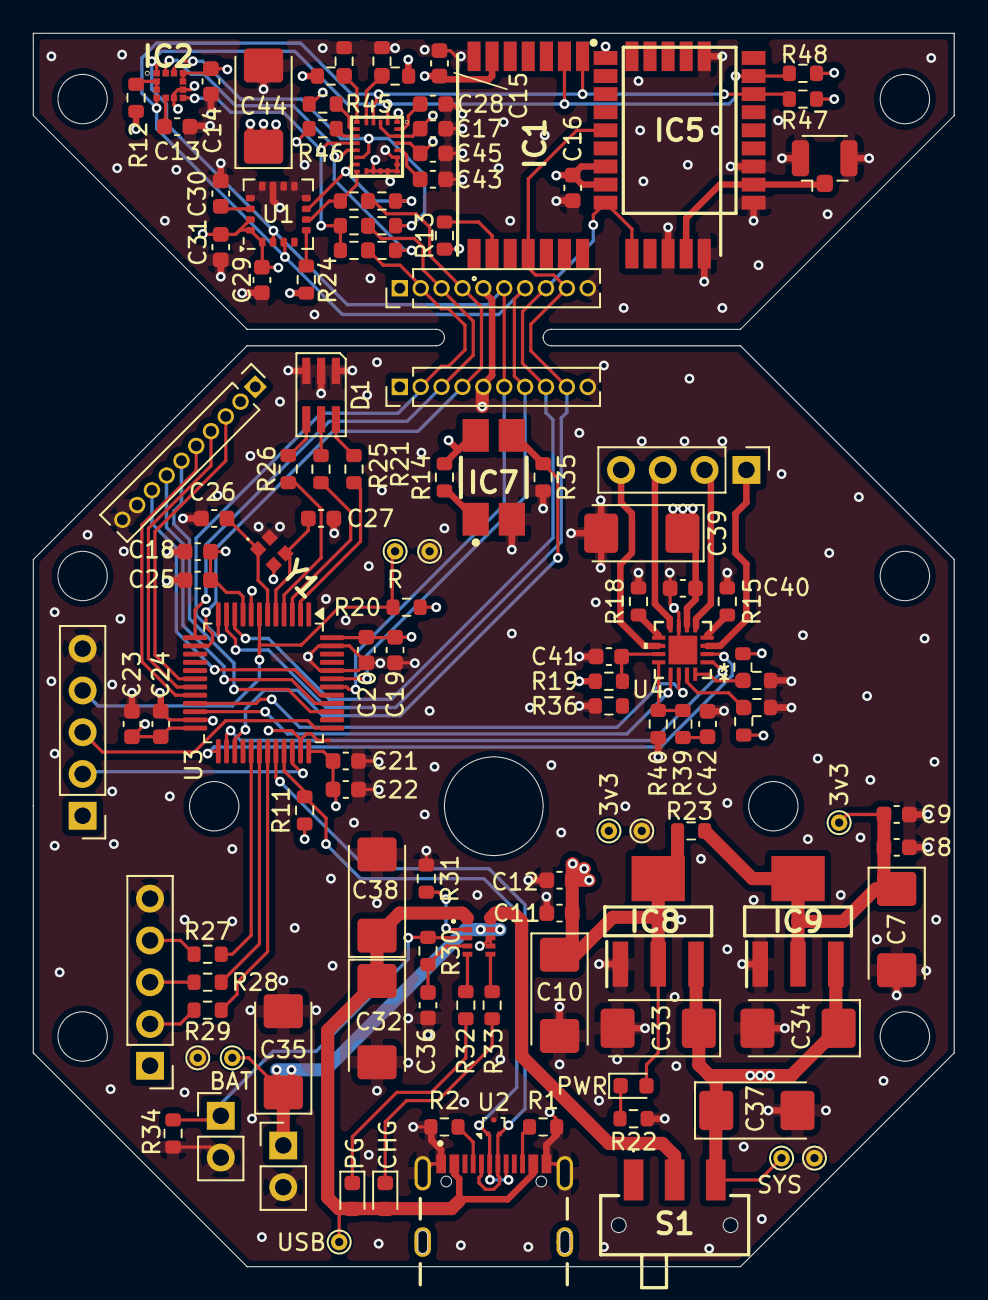
[picture p10: board SparrowCompass.kicad_pcb from above]

Board: 4 copper layers, 56.0 x 75.0 mm, 123 parts (0 on the bottom side), 83 nets.
