DicerosB/SparrowCompass/Software/CubeIDE/SparrowCompass/Core/Src/main.cpp

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
/* Includes ------------------------------------------------------------------*/
#include <MotorDriver.h>
#include "main.h"
#include "usb_device.h"


/* USER CODE BEGIN Includes */
#include "usbd_cdc_if.h"
#include <stdio.h>

/* USER CODE END Includes */

/* USER CODE BEGIN PD */
#define PROJECT_VERSION "0.0.1"
#define PROJECT_AUTHOR "M. Petzoldt"
#define DFU_BOOT_FLAG 0xDEADBEEF
/* USER CODE END PD */

I2C_HandleTypeDef hi2c1;

/* USER CODE BEGIN PV */
extern int _bflag;
uint32_t *dfu_boot_flag;
uint8_t hello_world_message[] =
               "\n~~~~~ Sparrow Compass ~~~~~~~\n Project Version: "
               PROJECT_VERSION "\n Author: " PROJECT_AUTHOR
               "\n~~~~~~~~~~~~~~~~~~~~~~~~~~~~~\n\n";
uint16_t loopcounter = 0;
uint8_t printf_usb_buffer[1024] = {0};
uint8_t *printf_usb_buffer_wpointer = (uint8_t *)&printf_usb_buffer;
/* USER CODE END PV */

void SystemClock_Config(void);
static void MX_GPIO_Init(void);
static void MX_I2C1_Init(void);
/**
  * @brief  The application entry point.
  * @retval int
  */
int main(void)
{

  /* MCU Configuration--------------------------------------------------------*/

  /* Reset of all peripherals, Initializes the Flash interface and the Systick. */
  HAL_Init();

  /* Configure the system clock */
  SystemClock_Config();

  /* USER CODE BEGIN SysInit */
  // printf routing
//  int _write(int file, char *ptr, int len) {
//      CDC_Transmit_FS((uint8_t*) ptr, len); return len;
//  }
  /* USER CODE END SysInit */

  /* Initialize all configured peripherals */
  MX_GPIO_Init();
  MX_I2C1_Init();
  MX_USB_DEVICE_Init();
  /* USER CODE BEGIN 2 */
  HAL_Delay(1000);
  CDC_Transmit_FS(hello_world_message, sizeof(hello_world_message)-1);
  /* USER CODE END 2 */
  MotorDriver *motor_driver;
  motor_driver = new(MotorDriver);
  /* Infinite loop */
  /* USER CODE BEGIN WHILE */

  while (1)
  {
	  HAL_Delay(1000);
	  printf("external_loaded%d\n", (int)loopcounter);
	  HAL_GPIO_WritePin(DEBUG_LED_GPIO_Port, DEBUG_LED_Pin, GPIO_PIN_RESET);
	  //motor_driver->spin(3200, 1000, 1);
	  HAL_Delay(100);
	  HAL_GPIO_WritePin(DEBUG_LED_GPIO_Port, DEBUG_LED_Pin, GPIO_PIN_SET);
	  HAL_Delay(100);
	  HAL_GPIO_WritePin(DEBUG_LED_GPIO_Port, DEBUG_LED_Pin, GPIO_PIN_RESET);
	  HAL_Delay(1000);
	  HAL_GPIO_WritePin(DEBUG_LED_GPIO_Port, DEBUG_LED_Pin, GPIO_PIN_SET);
    /* USER CODE END WHILE */

    /* USER CODE BEGIN 3 */
	  loopcounter++;
  }
  /* USER CODE END 3 */
}

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
/* USER CODE BEGIN 4 */
void switch_to_bootloader(){
	printf("now entering bootloader ..\n");
	fflush(stdout);
	//set bootloader flag
	dfu_boot_flag = (uint32_t*)(&_bflag);
	*dfu_boot_flag = DFU_BOOT_FLAG;
	HAL_NVIC_SystemReset();
}

void USB_CDC_RxHandler(uint8_t* Buf, uint32_t Len)
{
	char* ss;
	strncpy(ss, (char*)Buf, 8);
	if(Len <= 10 && !strcmp(ss, "deadbeef")){
		switch_to_bootloader();
	}else{
		CDC_Transmit_FS(Buf, Len);
	}

}

extern "C"
{
	int _write(int fd, char *ptr, int len){
	  (void)fd;
	  while(!(CDC_Transmit_FS((uint8_t*)ptr, len) == USBD_BUSY));
	  return len;
	}
}

//int __io_putchar(int ch)
//{
//	*printf_usb_buffer_wpointer = ch;
//	printf_usb_buffer_wpointer++;
//	uint16_t buffer_length = printf_usb_buffer_wpointer-printf_usb_buffer;
//	if((buffer_length>1023)|| ch == '\n'){
//		while(!(CDC_Transmit_FS(printf_usb_buffer, buffer_length) == USBD_BUSY));
//		printf_usb_buffer_wpointer = printf_usb_buffer;
//	}
//
//
//  return ch;
//}
/* USER CODE END 4 */
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
