DicerosB/SparrowCompass/Software/CubeIDE/SparrowCompass/SparrowCompass.ioc

Mcu.UserName=STM32L151CCTx
PA0-WKUP1.GPIO_Label=GPS_nReset
PA0-WKUP1.Signal=GPIO_Output
PA1.GPIO_Label=GPS_INT
PA1.Signal=GPXTI1
PA10.Signal=USART1_RX
PA11.Signal=USB_DM
PA12.Signal=USB_DP
PA13.Signal=SYS_JTMS-SWDIO
PA14.Signal=SYS_JTCK-SWCLK
PA2.GPIO_Label=MAG_DRDY
PA2.Signal=GPXTI2
PA3.GPIO_Label=MAG_INT1
PA3.Signal=GPXTI3
PA4.GPIO_Label=GYR_DRDY
PA4.Signal=GPXTI4
PA9.Signal=USART1_TX
PB11.GPIO_Label=MOT_nEnable
PB11.Signal=GPIO_Output
PB12.GPIO_Label=MOT_STEP
PB12.Signal=S_TIM10_CH1
PB13.GPIO_Label=MOT_DIR
PB13.Signal=GPIO_Output
PB14.GPIO_Label=MOT_SENS_B
PB14.Signal=GPXTI14
PB15.GPIO_Label=MOT_SENS_A
PB15.Signal=GPXTI15
PB6.Signal=I2C1_SCL
PB7.Signal=I2C1_SDA
PC13-WKUP2.GPIO_Label=DEBUG_LED
PC13-WKUP2.Signal=GPIO_Output
PH0-OSC_IN.Signal=RCC_OSC_IN
PH1-OSC_OUT.Signal=RCC_OSC_OUT
