DicerosB/SparrowCompass/Software/CubeIDE/SparrowCompass/Core/Inc/MotorDriver.h

/*
 * MotorDriver.h
 *
 *  Created on: Nov 25, 2025
 *      Author: Manue
 */
#ifndef SRC_MOTORDRIVER_H_
#define SRC_MOTORDRIVER_H_

#include <stdint.h>
#include <stdio.h>
#include "main.h"

class MotorDriver {
public:
	MotorDriver();
	void spin(uint16_t steps, int speed, bool dir);
};


#endif /* SRC_MOTORDRIVER_H_ */
