DicerosB/SparrowCompass/Software/CubeIDE/SparrowCompass/Core/Inc/MotorSensor.h

/*
 * MotorSensor.h
 *
 *  Created on: Nov 25, 2025
 *      Author: Manue
 */

#ifndef SRC_MOTORSENSOR_H_
#define SRC_MOTORSENSOR_H_

class Motor_Sensor {
public:
	Motor_Sensor();
};

#endif /* SRC_MOTORSENSOR_H_ */
