DicerosB/SparrowCompass/Software/CubeIDE/SparrowCompass/Core/Inc/BatteryManager.h

/*
 * BatteryManager.h
 *
 *  Created on: Nov 25, 2025
 *      Author: Manue
 */

#ifndef SRC_BATTERYMANAGER_H_
#define SRC_BATTERYMANAGER_H_

class BatteryManager {
public:
	BatteryManager();
};

#endif /* SRC_BATTERYMANAGER_H_ */
