DicerosB/SparrowCompass/Software/CubeIDE/SparrowCompass/Core/Inc/Gyroscope.h

/*
 * Gyroscope.h
 *
 *  Created on: Nov 25, 2025
 *      Author: Manue
 */

#ifndef SRC_GYROSCOPE_H_
#define SRC_GYROSCOPE_H_

class Gyroscope {
public:
	Gyroscope();
};

#endif /* SRC_GYROSCOPE_H_ */
