DicerosB/SparrowCompass/Software/CubeIDE/SparrowCompass/Core/Inc/Magnetometer.h

/*
 * Magnetometer.h
 *
 *  Created on: Nov 25, 2025
 *      Author: Manue
 */

#ifndef SRC_MAGNETOMETER_H_
#define SRC_MAGNETOMETER_H_

class Magnetometer {
public:
	Magnetometer();
};

#endif /* SRC_MAGNETOMETER_H_ */
