DicerosB/SparrowCompass/(commit log)

2025-11-19 added PCB-Design
    [BOM.xlsx, SparrowCompass Debug (1).cfg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]
2025-11-22 ENH: enabled usb communication and rerouted printf
2025-11-26 WIP: Motor control
2025-11-29 added Rev 2 Hardware
    [BOM.xlsx, SparrowCompass Debug (1).cfg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]
2025-12-01 init ardiono library
    [SparrowCompass.kicad_sch]
2025-12-04 FIX: CubeIDE project files
    [main.cpp]
2025-12-09 Improved Bootloader switching
2025-12-12 ENH: Added Aduino library and board structure
2025-12-12 DOC: Arduino library installation
2025-12-13 FIX Board manager defines
    [generic_clock.c, variant_generic.cpp]
2025-12-24 WIP: magnetometer i2c object
2025-12-24 FIX: i2c reference in module
2026-02-21 WIP: motor Timer
2026-02-22 FIX Motor initialisiation
2026-02-23 WIP Smooth Motor
2026-02-25 ENH constant motor acceleration
2026-04-10 FIX: Interrupt Object Access
2026-04-11 FIX Motor Interrupt
2026-04-12 WIP: additional timer for acceleration control
2026-04-26 WIP: Motor rewrote control concept
2026-04-26 FIX: smaller bugs, ENH more commands, motor debug via serial
2026-05-11 WIP: new hardware revision. WIP: motor debug
    [BOM.xlsx, EDI2CAP.CFG, EE-SX1320.stp, LDL1117S33R.SchLib, LDL1117S33R.stp, LSM9DS1TR.stp, SON110P970X1010X230-18N.PcbLib, SOT230P700X180-4N.PcbLib]
2026-05-22 ENH: Hardware v2
    [EDI2CAP.CFG, JS102011SAQN.PcbLib, JS102011SAQN.SchLib, JS102011SAQN.stp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]
2026-05-22 WIP Magnetometer
2026-05-27 ENH: Magnetometer, Plotting function
2026-06-11 Gerber export
    [SparrowCompass-B_Cu.gbr, SparrowCompass-B_Mask.gbr, SparrowCompass-B_Paste.gbr, SparrowCompass-B_Silkscreen.gbr, SparrowCompass-Edge_Cuts.gbr, SparrowCompass-F_Cu.gbr, SparrowCompass-F_Mask.gbr, SparrowCompass-F_Paste.gbr]
2026-07-23 ENH: Added Alternative Modul Addresses
    [SparrowCompass.csv]
2026-08-27 ENH: implemented alternative magnetometer
2026-08-27 ENH: selective sensor plotting
2026-08-27 WIP: alt. accelerometer
