DicerosB/SparrowCompass/(notices)

Notices in the files:
Software/CubeIDE/SparrowCompass/Core/Inc/main.h:
Copyright (c) 2025 STMicroelectronics.
All rights reserved.
This software is licensed under terms that can be found in the LICENSE file
